muhammedguler/ESP32-ECG-HOLTER/PCB/Bill Of Materials EKG HOLTER.pdf

## Bill Of Materials for EKG HOLTER

Design Title | EKG HOLTER
Author | Muhammed Güler
Document Number | 001
Revision | 1.2
Design Created | Friday, October 27, 2023
Design Last Modified Friday, November 3, 2023

### Total Parts In Design 137

0 Modules
Quantity References | Value | Stock Code | Unit
Cost
Sub-totals: | | | | $0.00
42 Capacitors
Quantity References | Value | Stock Code | Unit
| | | | Cost
3 | C1,C37,C41 | GRM31CR61A107MEA8L | 490-GRM31CR61A107MEA8LCT-
| | | ND (https://www.digikey.com/en/products/detail/murata-electronics/grm31cr61a107mea8l/16033775) | $0.29
17 | C2,C4,C7,C11,C13,C18,C20-C22,C31,
| C33-C34,C36,C38-C40,C42 | CL10B104KB8NNWC | 1276-1935-1-ND (https://www.digikey.com/en/products/detail/samsung-electro-mechanics/CL10B104KB8NNWC/3887593) | $0.02
1 | C3 | CL10B102KB8NNNC | 1276-1018-1-ND (https://www.digikey.com/en/products/detail/samsung-electro-mechanics/CL10B102KB8NNNC/3886676) | $0.03
2 | C5-C6 | CL10C220JB81PNC | 1276-2226-1-ND (https://www.digikey.com/en/products/detail/samsung-electro-mechanics/CL10C220JB81PNC/3887884) | $0.04
2 | C8-C9 | CL10C040CB8NNNC | 1276-1789-1-ND (https://www.digikey.com/en/products/detail/samsung-electro-mechanics/CL10C040CB8NNNC/3887447) | $0.03
11 | C10,C12,C14,C16,C19,C25-C27,C30, | | GRM188R61E106KA73J | 490-GRM188R61E106KA73JCT- | $0.16
C32,C35 | | ND (https://www.digikey.com/en/products/detail/murata-electronics/GRM188R61E106KA73J/9887674)
6 | C15,C17,C23-C24,C28-C29 | TMK107ABJ225KA-T | 587-2909-1-ND (https://www.digikey.com/en/products/detail/taiyo-yuden/TMK107ABJ225KA-T/2648986) | $0.12
Sub-totals: | | | | $3.80
46 Resistors
Quantity References | Value | Stock Code | Unit
| | | | Cost
15 | R1-R5,R7,R12-R13,R15-R16,R34,R37, R43,R45-R46 | 10k | 13-RC0603FR-1010KLCT-ND (https://www.digikey.com/en/products/detail/yageo/RC0603FR-1010KL/12756395) | $0.01
3 | R6,R26,R35 | 0R | 311-0.0GRCT-ND (https://www.digikey.com/en/products/detail/yageo/RC0603JR-070RL/726675) | $0.01
1 | R8 | 10M | 311-10MGRCT-ND (https://www.digikey.com/en/products/detail/yageo/RC0603JR-0710ML/726701) | $0.01
4 | R9,R11,R42,R44 | 220 | 311-220HRCT-ND (https://www.digikey.com/en/products/detail/yageo/RC0603FR-07220RL/727061) | $0.01
5 | R10,R20,R27-R28,R31 | 330 | 13-RC0603FR-10330RLCT-ND (https://www.digikey.com/en/products/detail/yageo/RC0603FR-10330RL/13694144) | $0.01
5 | R14,R17,R36,R38,R40 | 22.6k | 311-22.6KHRCT-ND (https://www.digikey.com/en/products/detail/yageo/RC0603FR-0722K6L/727060) | $0.01
6 | R18-R19,R32-R33,R39,R41 | 100k | 13-RC0603FR-10100KLCT-ND (https://www.digikey.com/en/products/detail/yageo/RC0603FR-10100KL/13694231) | $0.01
5 | R21-R25 | CRCW120622K0FKEAHP | 541-22.0KUCT-ND (https://www.digikey.com/en/products/detail/vishay-dale/CRCW120622K0FKEAHP/2227891) | $0.11
2 | R29-R30 | 1M | 13-RC0603FR-131MLCT-ND (https://www.digikey.com/en/products/detail/yageo/RC0603FR-131ML/13694152) | $0.01
Sub-totals: | | | | $0.94
8 Integrated Circuits
Quantity References | Value | Stock Code | Unit
| | | | Cost
1 | U1 | ADS1293CISQ_NOPB | 296-39852-1-ND (https://www.digikey.com/en/products/detail/texas-instruments/ADS1293CISQ-NOPB/3749460) | $16.02
1 | U2 | MCP7940NT-I_SN | MCP7940NT-I/SNCT-ND (https://www.digikey.com/en/products/detail/microchip-technology/MCP7940NT-I-SN/2665116) | $0.85
1 | U3 | XC6193AA10ER-G | 893-XC6193AA10ER-GCT-ND (https://www.digikey.com/en/products/detail/torex-semiconductor-ltd/XC6193AA10ER-G/12325035) | $0.88
1 | U4 | ESP32-S3-WROOM-1 | 1965-ESP32-S3-WROOM-1- N8CT-ND (https://www.digikey.com/en/products/detail/espressif-systems/ESP32-S3-WROOM-1-N8/15200089) | $3.20
1 | U5 | M24C16-RMN6TP
1 | U6 | MAX77751CEFG | 175-MAX77751CEFG+-ND (https://www.digikey.com/en/products/detail/analog-devices-inc-maxim-integrated/MAX77751CEFG/13157987) | $3.61
1 | U7 | TLV62568PDDCR | 296-50491-1-ND (https://www.digikey.com/en/products/detail/texas-instruments/TLV62568PDDCR/7915913) | $0.38
1 | U8 | MIC2876-AYMT-TR | MIC2876-AYMT-CT-ND (https://www.digikey.com/en/products/detail/microchip-technology/MIC2876-AYMT-TR/5283841) | $0.97
Sub-totals: | | | | $25.91
5 Transistors

Quantity References | Value | Stock Code | Unit
Cost
1 | Q1 | SSM3J328R_LF | SSM3J328RLFCT-ND (https://www.digikey.com/en/products/detail/toshiba-semiconductor-and-storage/SSM3J328R-LF/2753199) | $0.39
4 | Q2-Q5 | NX138BKR | 1727-2662-1-ND (https://www.digikey.com/en/products/detail/nexperia-usa-inc/NX138BKR/5981270) | $0.21
Sub-totals: | | | | $1.23
1 Diodes
Quantity References | Value | Stock Code | Unit
| | | | Cost
1 | D1 | CUS520_H3F | CUS520H3FCT-ND (https://www.digikey.com/en/products/detail/toshiba-semiconductor-and-storage/CUS520-H3F/5114303) | $0.20
Sub-totals: | | | | $0.20
35 Miscellaneous
Quantity References | Value | Stock Code | Unit
| | | | Cost
1 | BAT1 | BK-869 | BK-869-ND (https://www.digikey.com/en/products/detail/mpd-memory-protection-devices/BK-869/2439465) | $0.56
1 | BAT2 | SWR25X-NRTC-S02-RB-BA | S9499-ND (https://www.digikey.com/en/products/detail/sullins-connector-solutions/SWR25X-NRTC-S02-RB-BA/2769660) | $0.15
1 | BATA1 | SWH25X-NULC-S02-UU-BA | S9435-ND (https://www.digikey.com/en/products/detail/sullins-connector-solutions/SWH25X-NULC-S02-UU-BA/2411477) | $0.03
2 | BATB1-BATB2 | SWT25X-URTC-S01-UU-UU | S9473CT-ND (https://www.digikey.com/en/products/detail/sullins-connector-solutions/SWT25X-URTC-S01-UU-UU/2769651) | $0.06
2 | BTN1-BTN2 | TS14-1212-100-BK-160-SCR-
| | D | 2223-TS14-1212-100-BK-160- SCR-D-ND (https://www.digikey.com/en/products/detail/cui-devices/TS14-1212-100-BK-160-SCR-D/16562757) | $0.24
2 | BTNN1-BTNN2 | PTS647SK38SMTR2LFS | PTS647SK38SMTR2LFSCT-ND (https://www.digikey.com/en/products/detail/c-k/PTS-647-SK38-SMTR2-LFS/9649862) | $0.20
1 | BUZZER1 | SMT-0825-S-HT-R | 668-SMT-0825-S-HT-RCT-ND (https://www.digikey.com/en/products/detail/pui-audio-inc/SMT-0825-S-HT-R/13165908) | $1.13
5 | ECG1-ECG5 | DIN42802-1 | DIN42802-1 (https://www.aliexpress.com/i/2251832820496981.html?gatewayAdapt=bra2glo4itemAdapt) | $5.00
5 | ESD1-ESD5 | ESD03A5V5R17V | ESD03A5V5R17VCT-ND (https://www.digikey.com/en/products/detail/stackpole-electronics-inc/ESD03A5V5R17V/2239266) | $0.18
3 | L1,L3,L5 | BLM18KG102SN1D | 490-17349-1-ND (https://www.digikey.com/en/products/detail/murata-electronics/BLM18KG102SN1D/7798421) | $0.10
3 | L2,L4,L6 | SRP3212A-3R3M | 118-SRP3212A-3R3MCT-ND (https://www.digikey.com/en/products/detail/bourns-inc/SRP3212A-3R3M/16546469) | $0.27
1 | LED1 | B38G3RGB-10D0003H2U1930 | 3147- B38G3RGB-10D0003H2U1930CT-
| | | ND (https://www.digikey.com/en/products/detail/harvatek-corporation/B38G3RGB-10D0003H2U1930/13588733) | $0.11
1 | NTC1 | NCU18XH103E60RB | 490-18164-1-ND (https://www.digikey.com/en/products/detail/murata-electronics/NCU18XH103E60RB/8323959) | $0.06
1 | PROG1 | 61300611121 | 732-5319-ND (https://www.digikey.com/en/products/detail/w%C3%BCrth-elektronik/61300611121/4846833) | $0.30
1 | SD1 | 0475710001 | WM9731CT-ND (https://www.digikey.com/en/products/detail/molex/0475710001/3262277?s=N4IgTCBcDaIAwBYDsBWJBGOX0gLoF8g) | $1.15
1 | TVS1 | USBLC6-2SC6 | 497-5235-1-ND (https://www.digikey.com/en/products/detail/stmicroelectronics/USBLC6-2SC6/1040559) | $0.61
1 | TVS2 | EMIF06-MSD02N16 | 497-8751-1-ND (https://www.digikey.com/en/products/detail/stmicroelectronics/EMIF06-MSD02N16/2043592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) | $1.12
1 | USB1 | USB4105GFA | 2073-USB4105-GF-ACT-ND (https://www.digikey.com/en/products/detail/gct/USB4105-GF-A/11198441) | $0.81
1 | X1 | SC32S-7PF20PPM | 728-1074-1-ND (https://www.digikey.com/en/products/detail/seiko-instruments/SC32S-7PF20PPM/4931504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) | $0.38
1 | X2 | ABLS-4 | 535-14922-1-ND (https://www.digikey.com/en/products/detail/abracon-llc/ABLS-4-096MHZ-20-B-4-Y-T/9997830) | $0.24
Sub-totals: | | | | $34.66
Totals: | | | | $66.74

Wednesday, January 10, 2024 7:30:53 PM
