muhammedguler/ESP32-ECG-HOLTER/PCB/sema.PDF

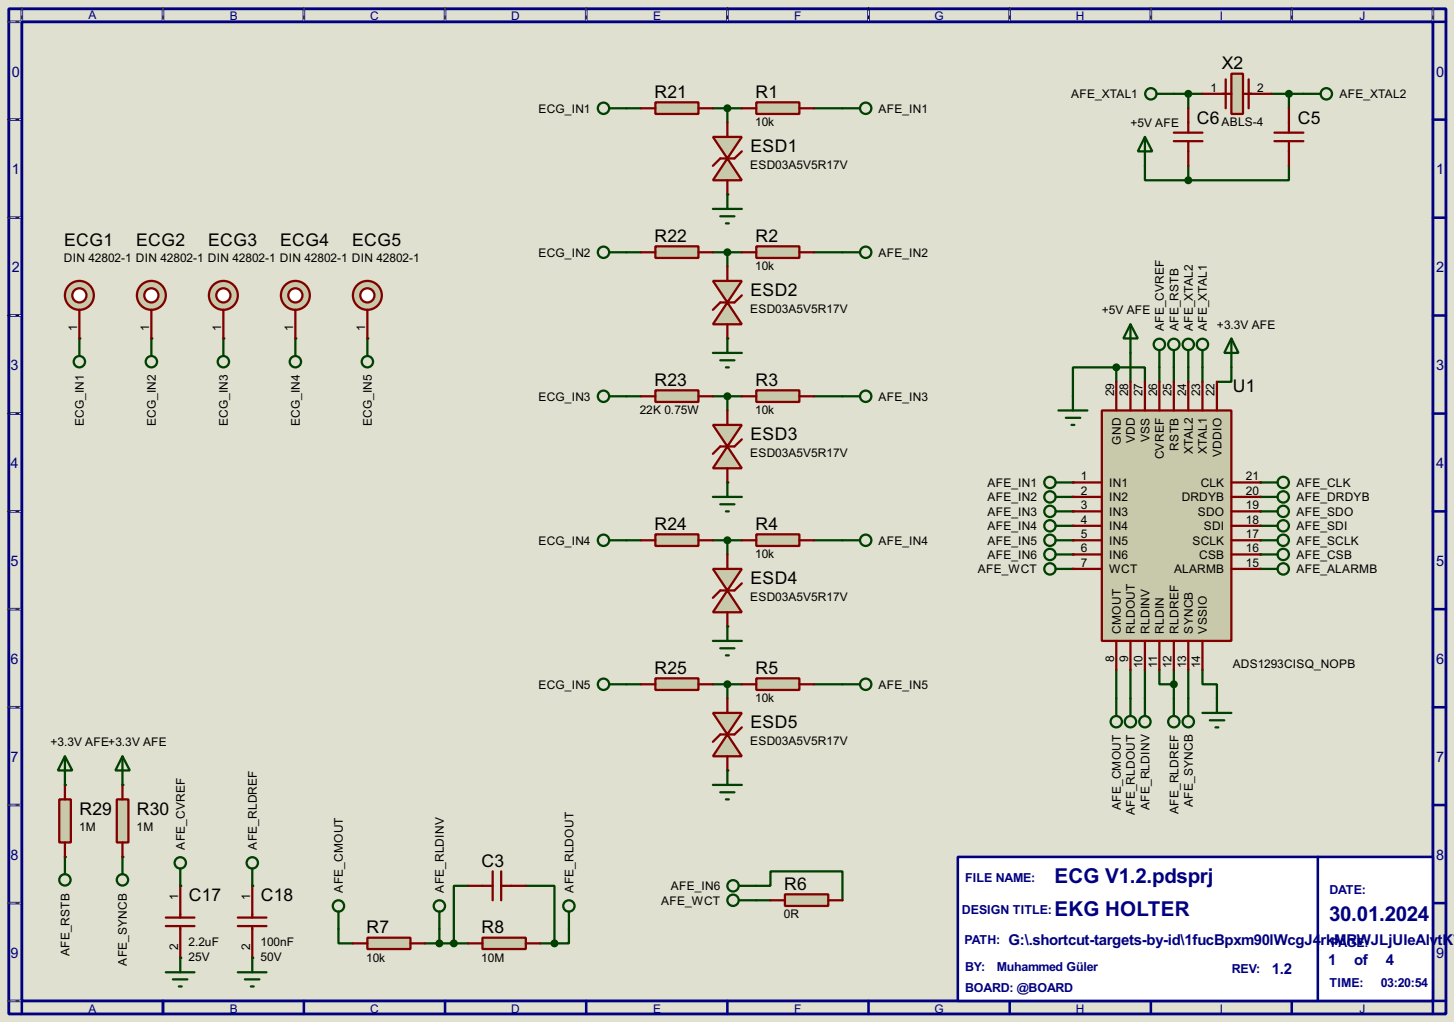
[picture p1: page 1]

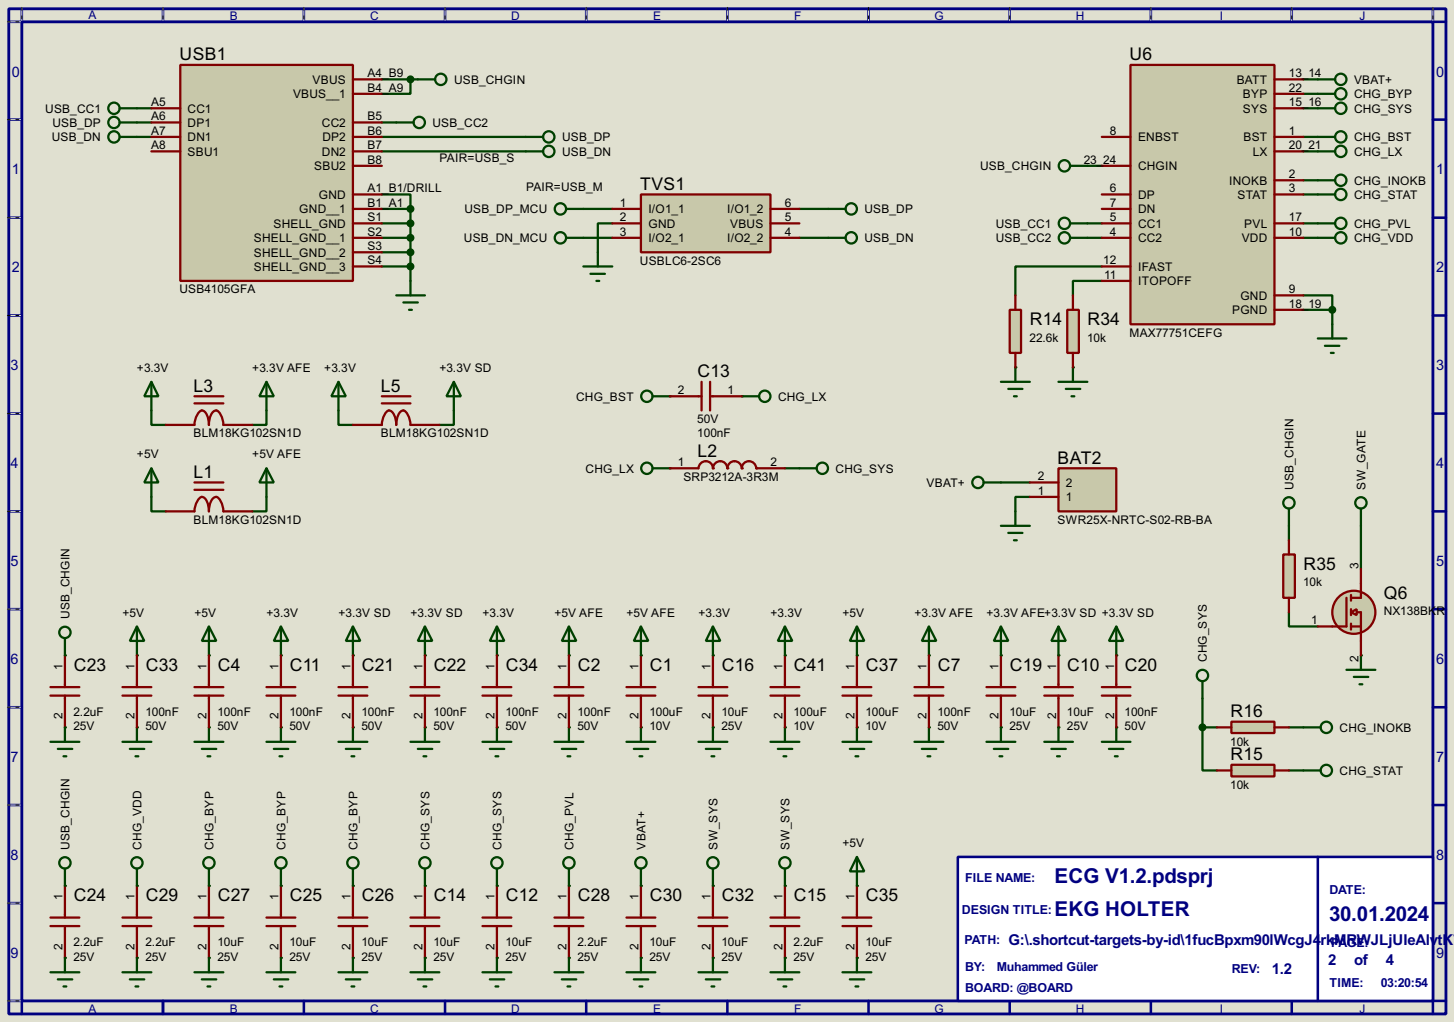
[picture p2: page 2]

DESIGN TITLE:EKG HOLTER

Muhammed Güler PATH: G:\.shortcut-targets-by-id\1fucBpxm90lWcgJ4rkMRWJLjUIeAlvtK7\Muhammed Güler\PCB\ECG V1.2.pdsprj

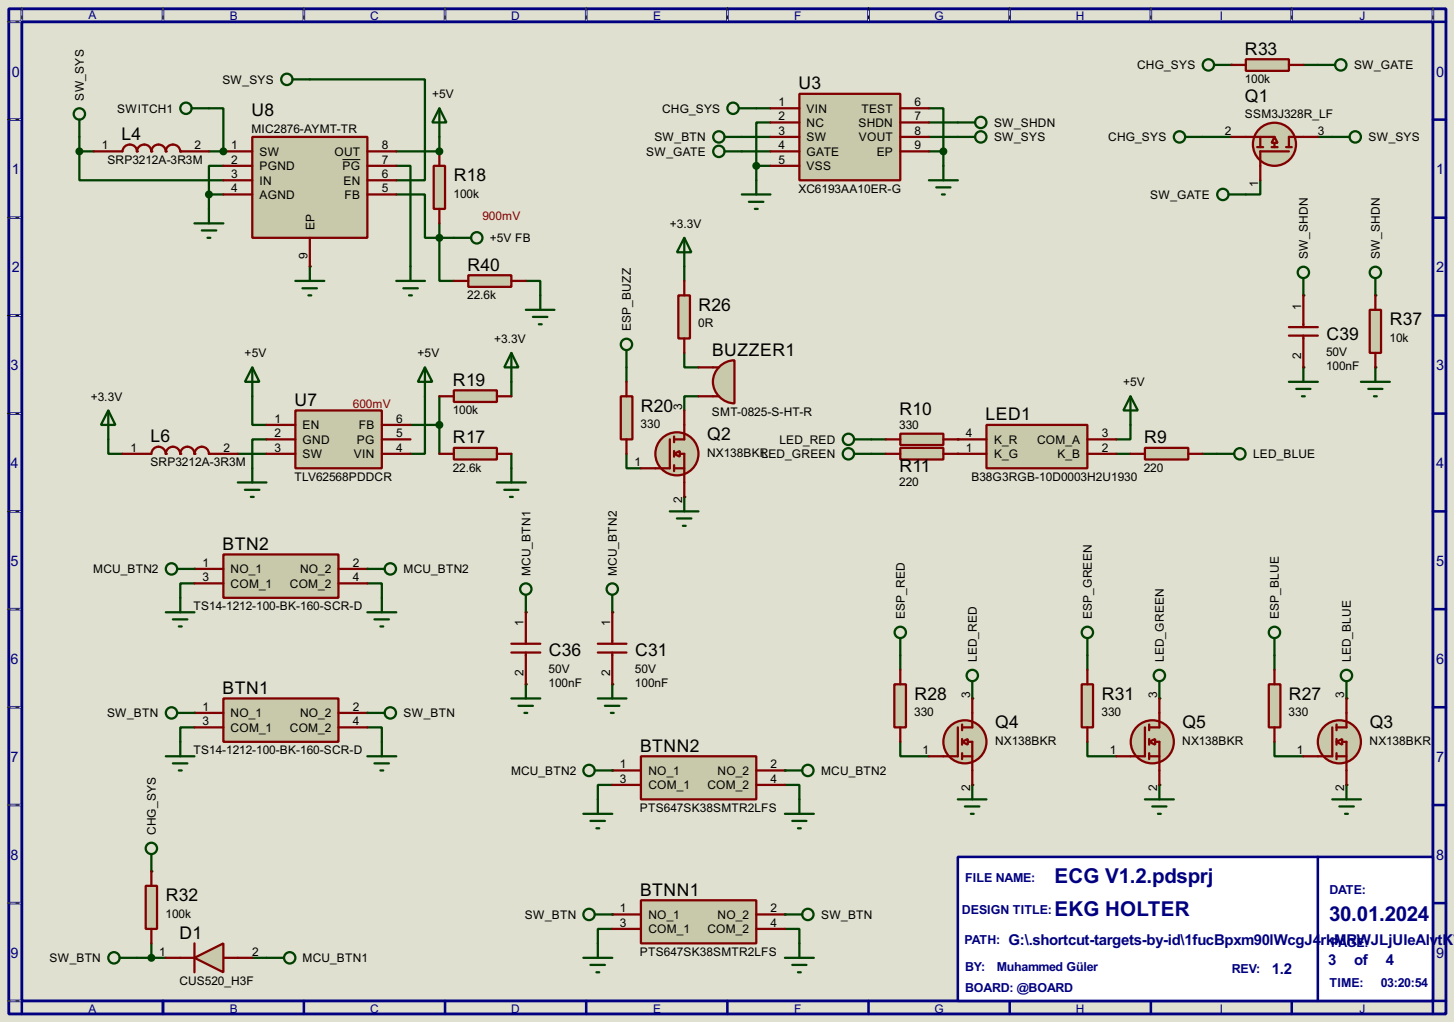
[picture p3: page 3]

DESIGN TITLE:EKG HOLTER

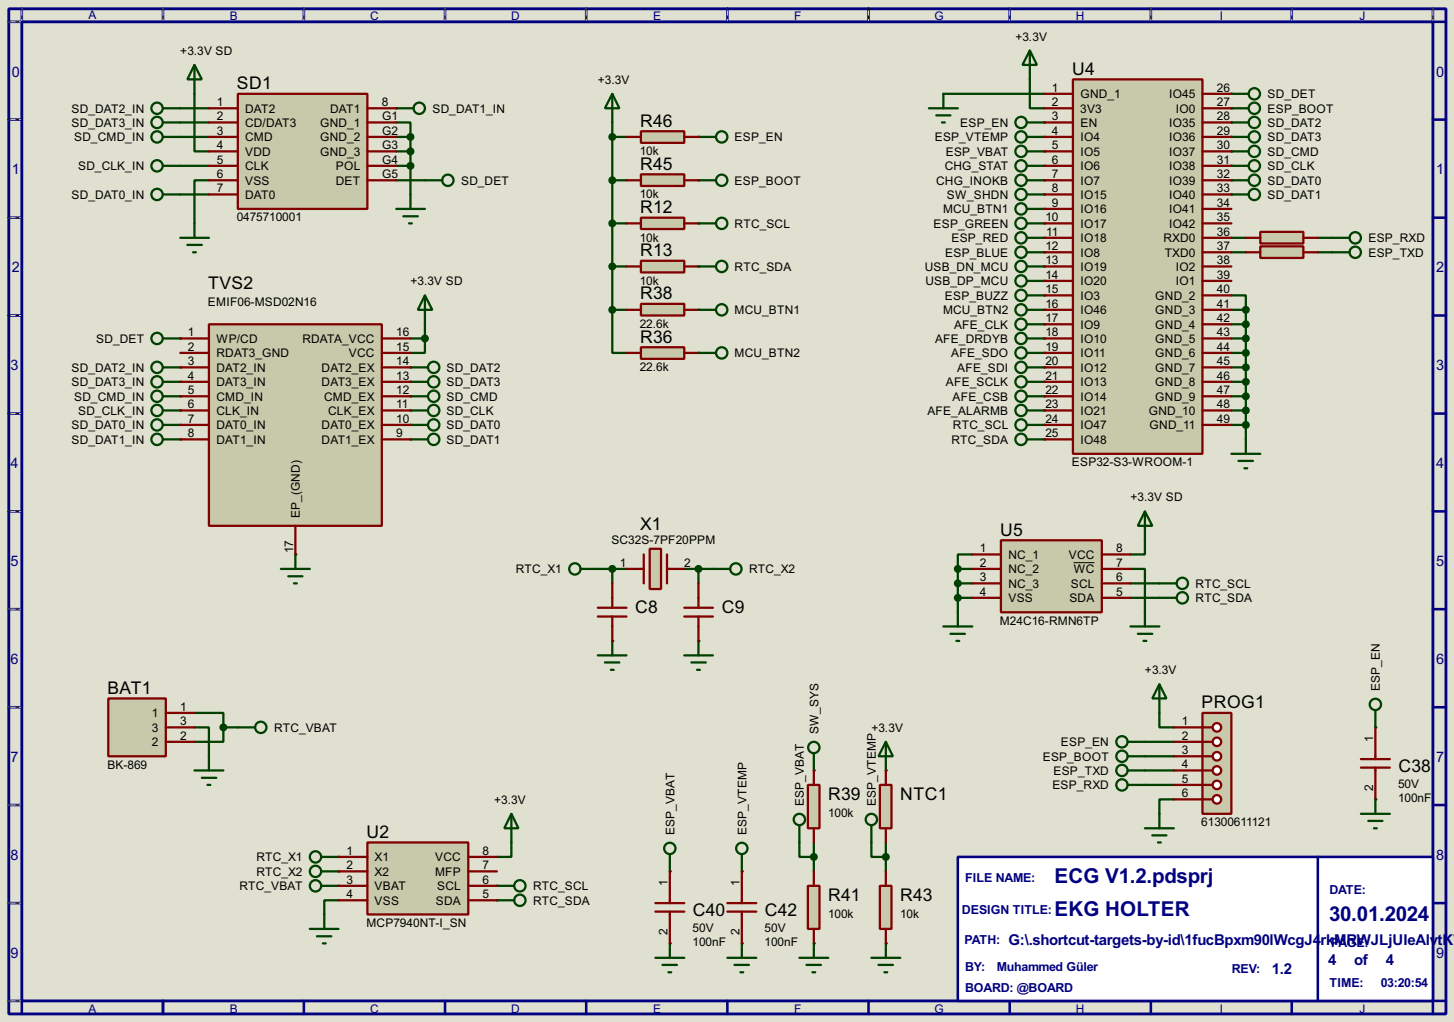
[picture p4: page 4]

DESIGN TITLE:EKG HOLTER
