muhammedguler/ESP32-ECG-HOLTER/PCB/ECG V1.3.PDF

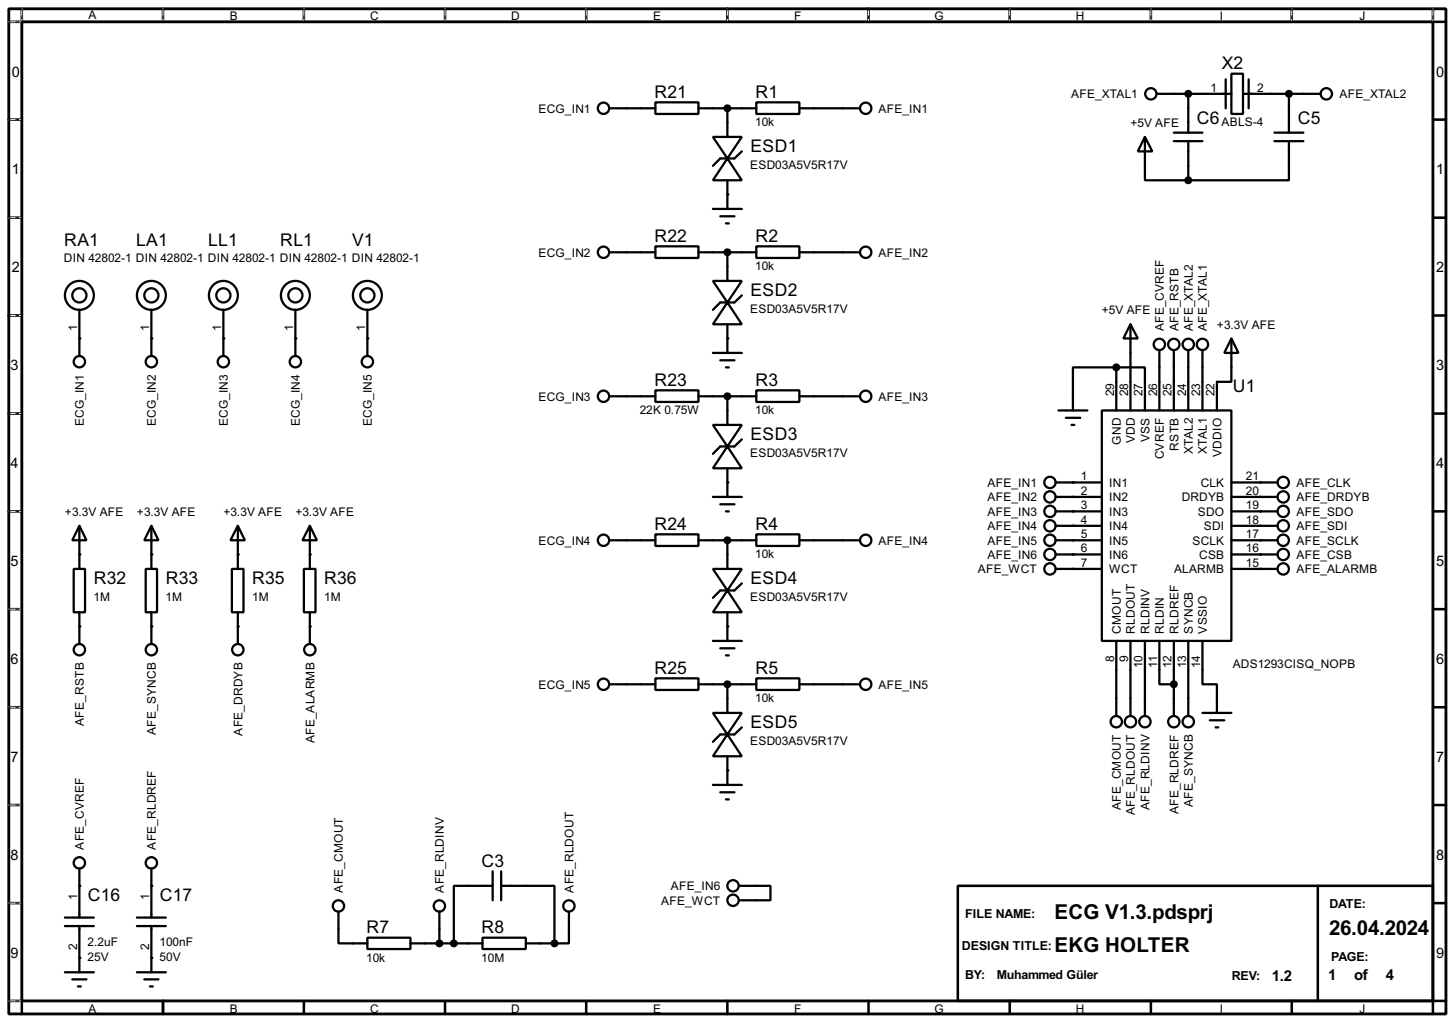
[picture p5: page 1]

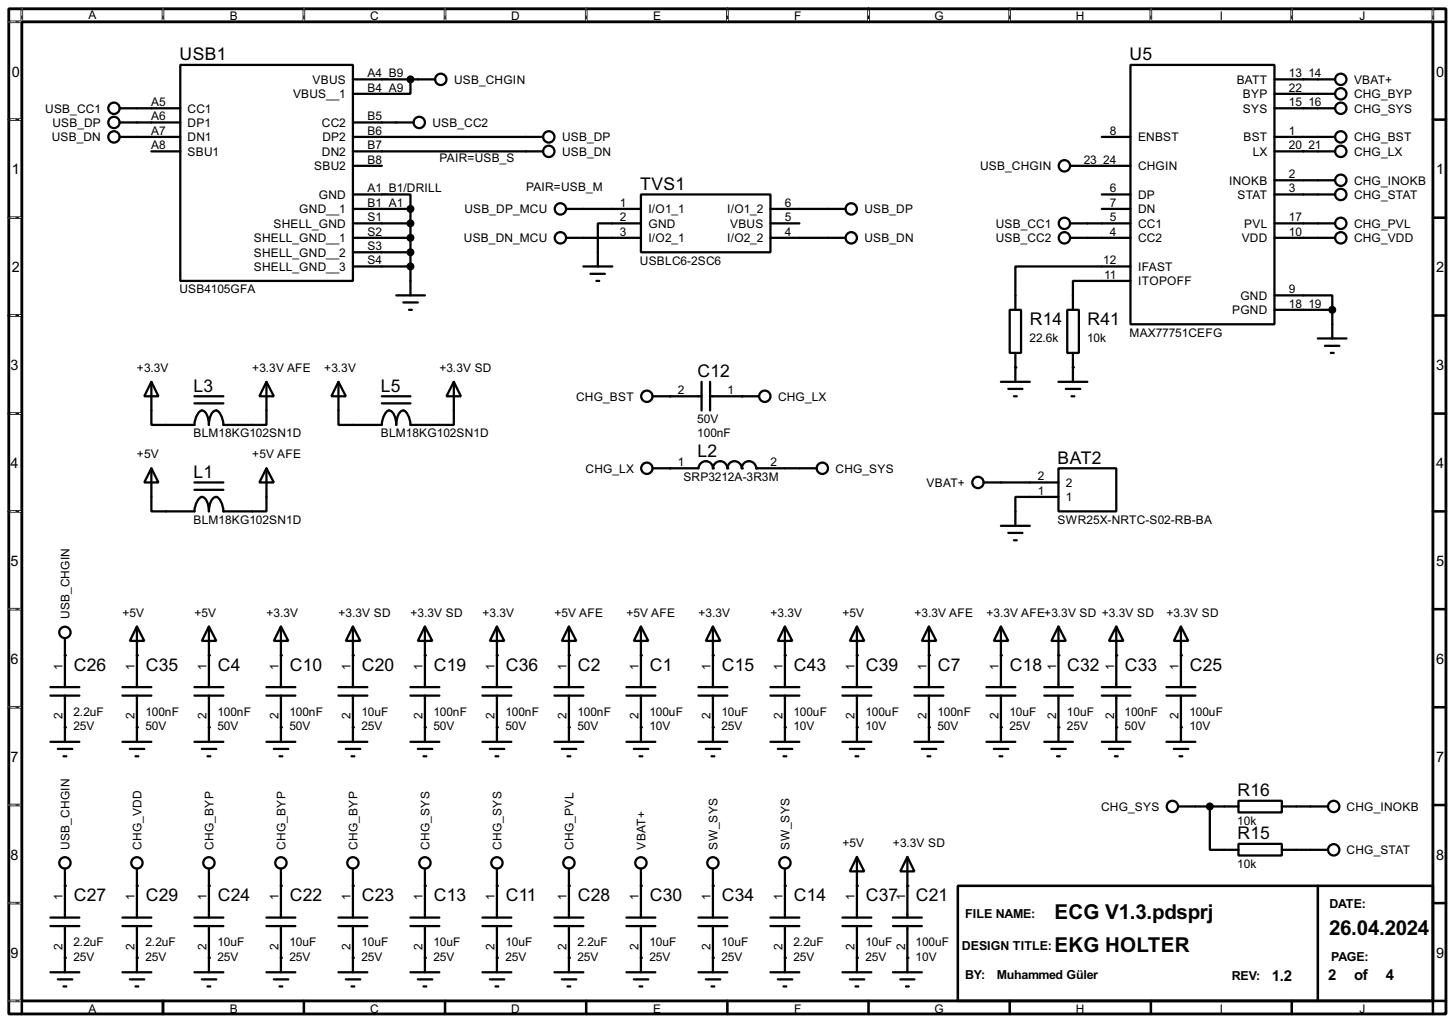
[picture p6: page 2]

DESIGN TITLE:EKG HOLTER

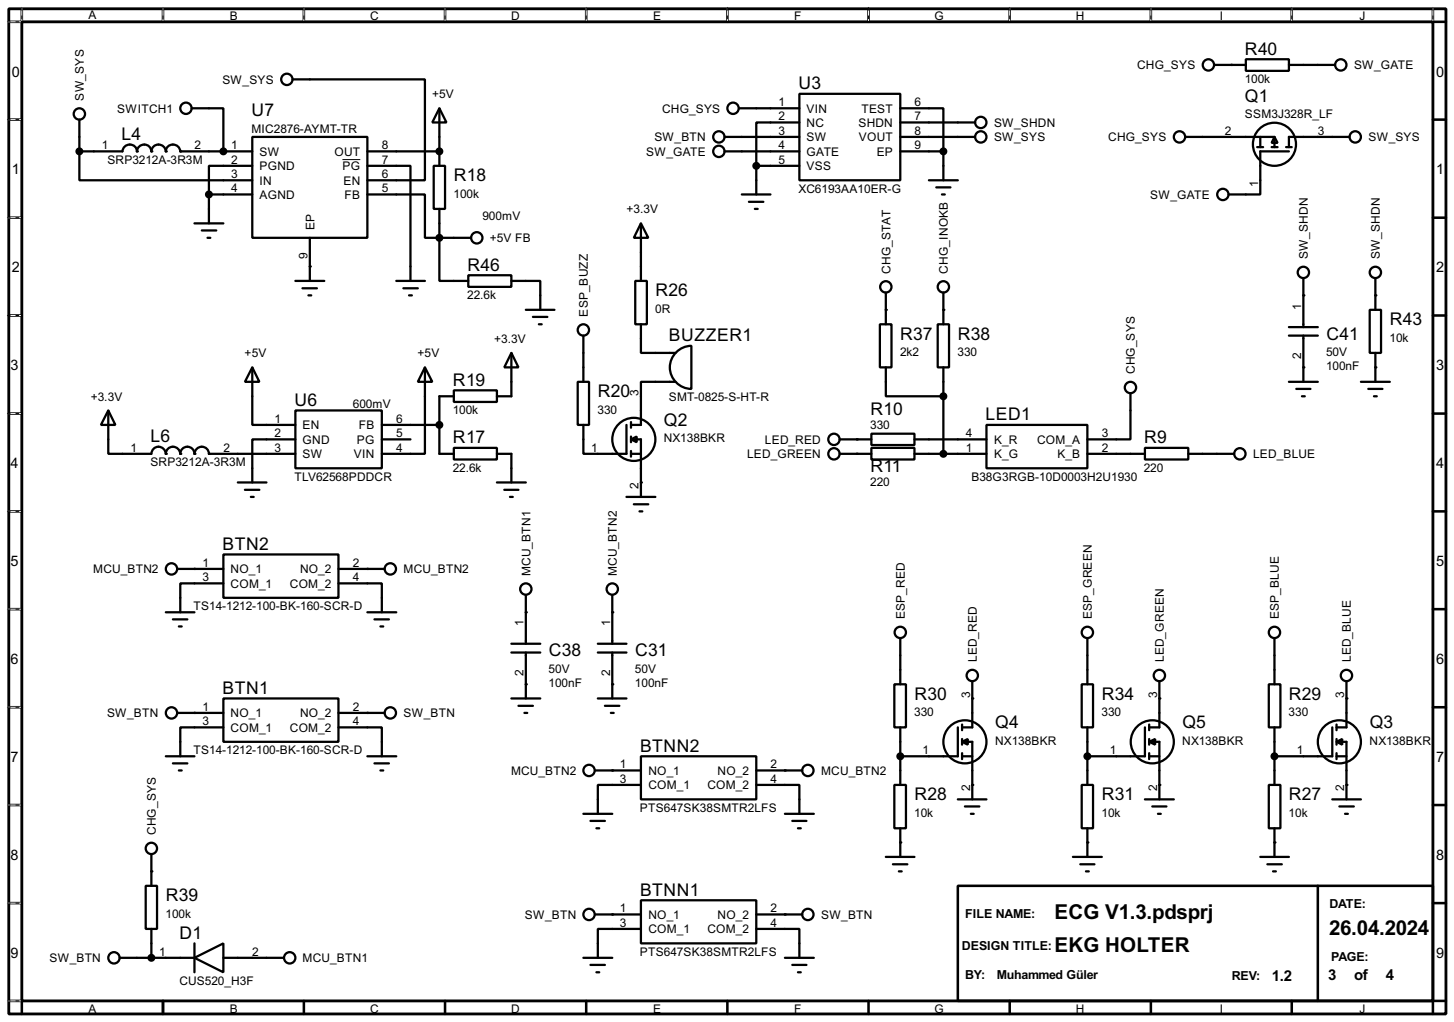
[picture p7: page 3]

DESIGN TITLE:EKG HOLTER SW_BTN

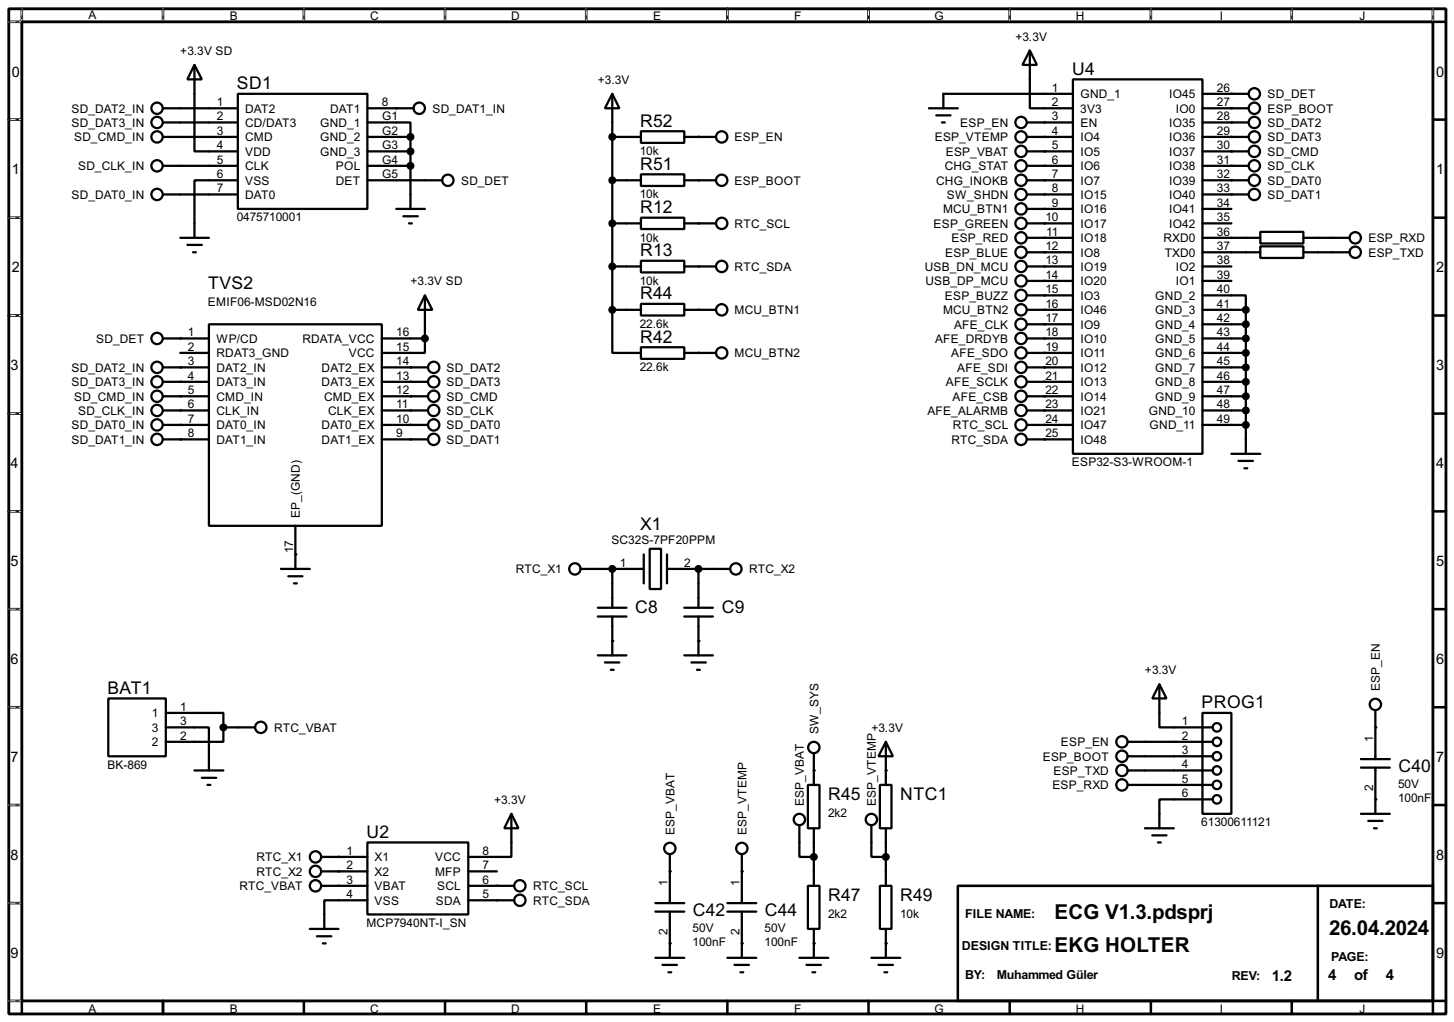
[picture p8: page 4]

DESIGN TITLE:EKG HOLTER
