muhammedguler/ESP32-ECG-HOLTER/PCB/ECG V1.2.PDF

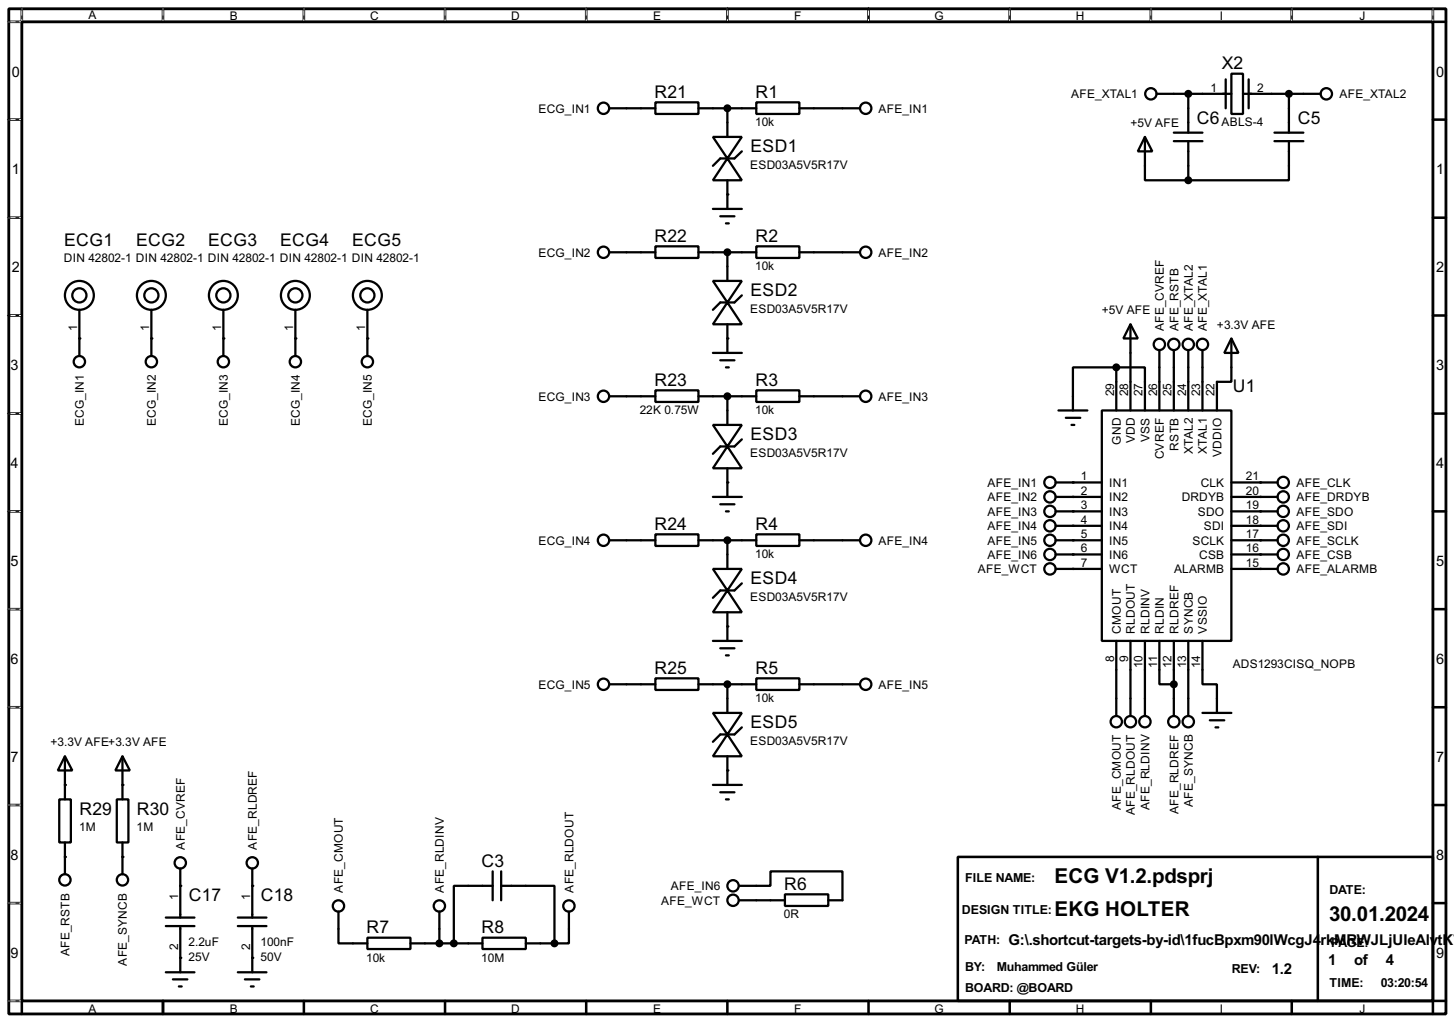
[picture p19: page 1]

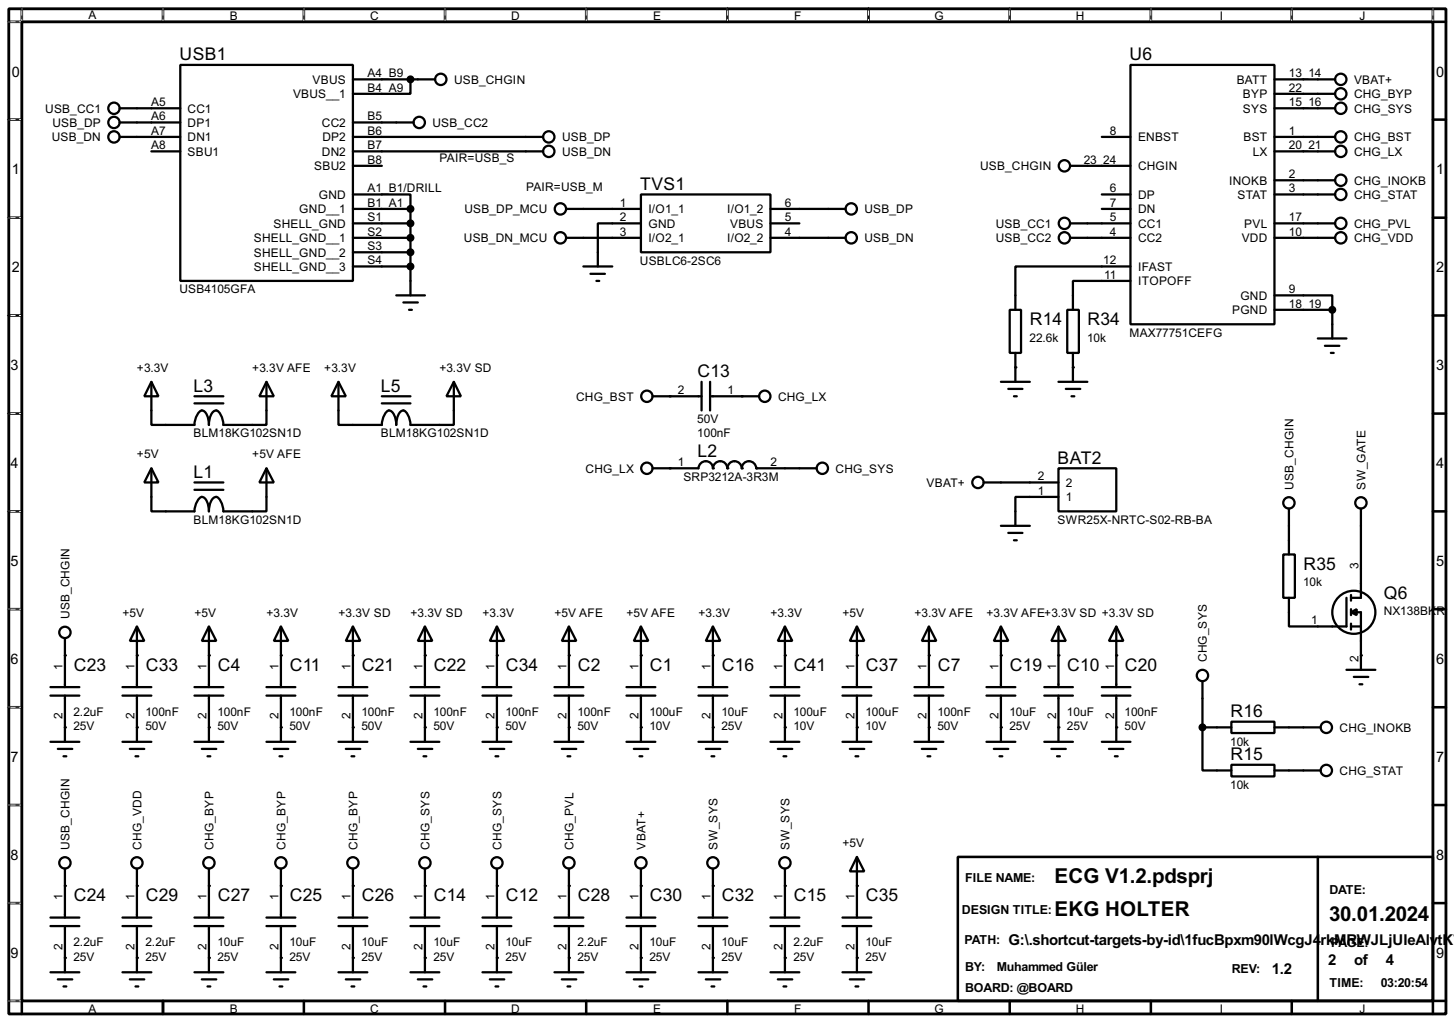
[picture p20: page 2]

DESIGN TITLE:EKG HOLTER

Muhammed Güler PATH: G:\.shortcut-targets-by-id\1fucBpxm90lWcgJ4rkMRWJLjUIeAlvtK7\Muhammed Güler\PCB\ECG V1.2.pdsprj

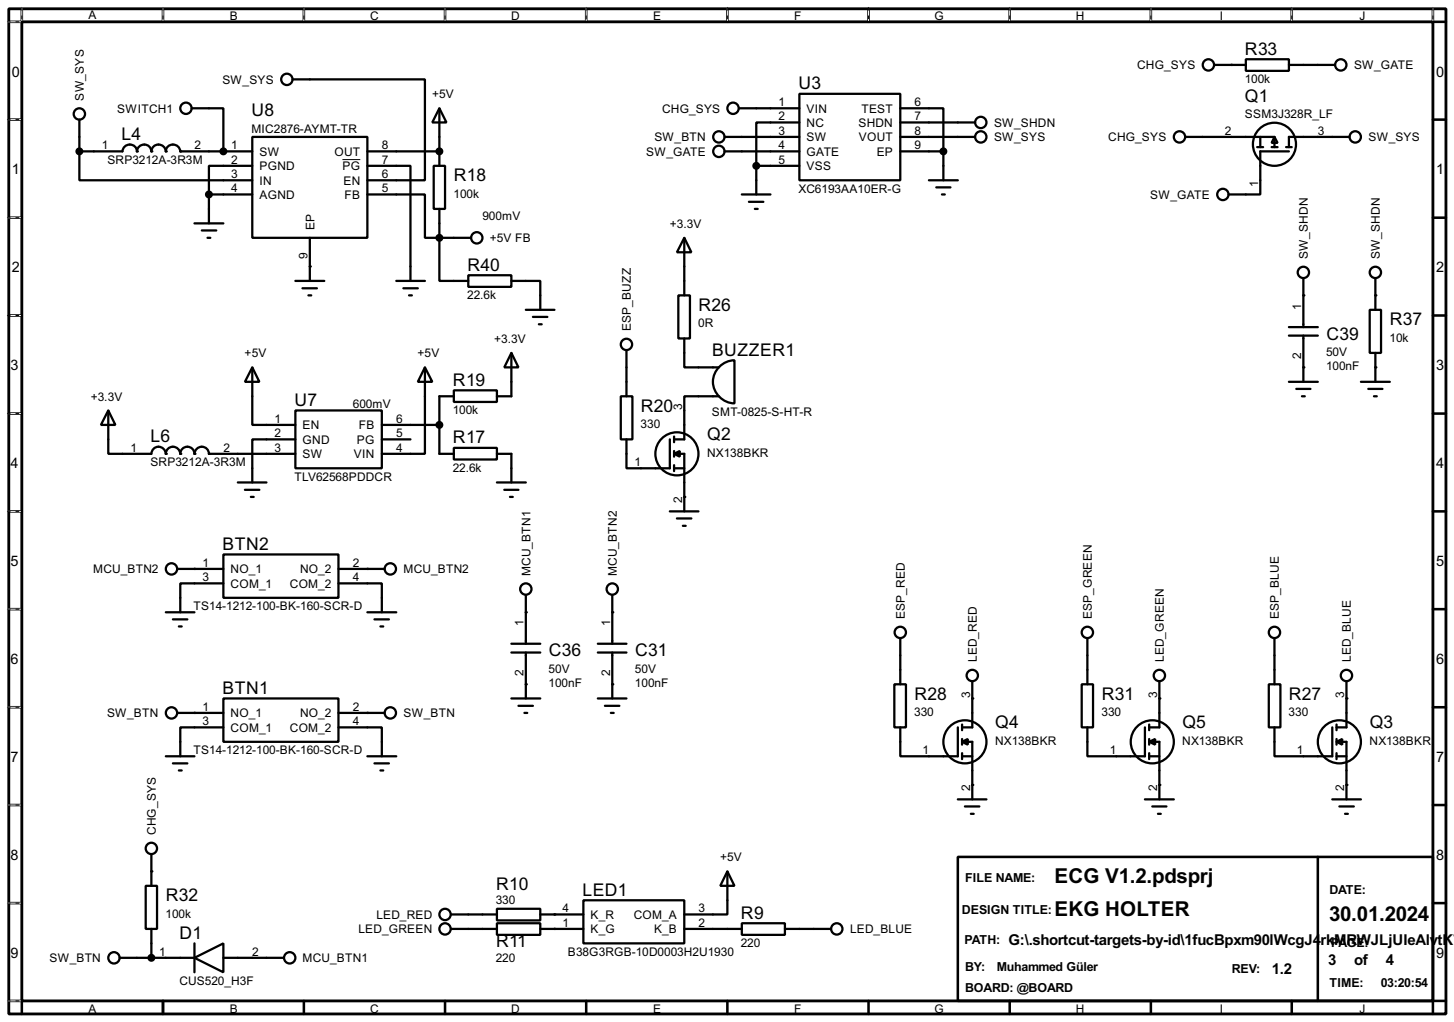
[picture p21: page 3]

DESIGN TITLE:EKG HOLTER

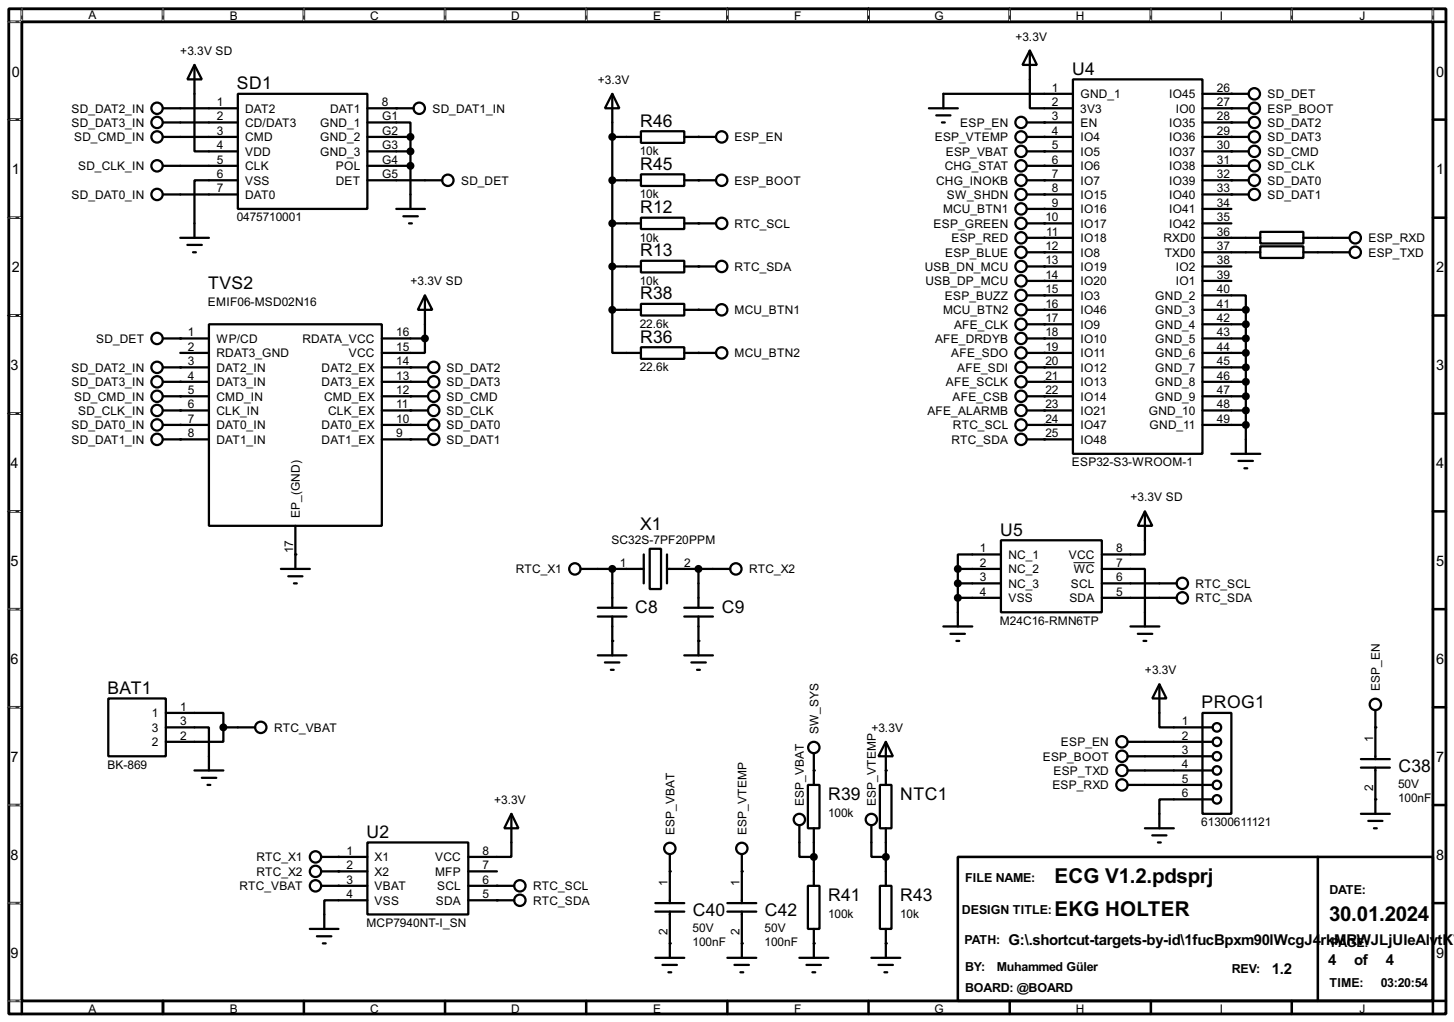
[picture p22: page 4]

DESIGN TITLE:EKG HOLTER
