muhammedguler/ESP32-ECG-HOLTER/(list of files, drawings)

Other design files:
PCB/ECG V1.1.pdsprj
PCB/ECG V1.2.pdsprj
PCB/ECG V1.3.pdsprj
PCB/ECG.pdsprj
PCB/Project Backups/ECG V1.2 [20240424, 11-50-18].pdsprj
PCB/Project Backups/ECG V1.2 [20240424, 11-50-30].pdsprj
PCB/Project Backups/ECG V1.2 [20240424, 11-51-49].pdsprj
PCB/Project Backups/ECG V1.2 [20240424, 11-51-51].pdsprj
PCB/Project Backups/ECG V1.2 [20240424, 13-41-26].pdsprj
PCB/Project Backups/ECG V1.2 [20240424, 13-41-31].pdsprj
PCB/Project Backups/ECG V1.2 [20240424, 17-04-33].pdsprj
PCB/Project Backups/ECG V1.2 [20240424, 17-05-45].pdsprj
PCB/Project Backups/ECG V1.2 [20240424, 17-06-13].pdsprj
PCB/Project Backups/ECG V1.2 [20240424, 17-39-44].pdsprj
PCB/Project Backups/ECG V1.3 [20240425, 14-21-31].pdsprj
PCB/Project Backups/ECG V1.3 [20240425, 14-24-04].pdsprj
PCB/Project Backups/ECG V1.3 [20240425, 14-36-05].pdsprj
PCB/Project Backups/ECG V1.3 [20240426, 11-07-48].pdsprj
PCB/Project Backups/ECG V1.3 [20240426, 11-11-24].pdsprj
PCB/Project Backups/ECG V1.3 [20240426, 11-27-17].pdsprj
PCB/Project Backups/ECG V1.3 [20240426, 11-27-18].pdsprj
PCB/Project Backups/ECG V1.3 [20240426, 11-27-19].pdsprj
PCB/Project Backups/ECG V1.3 [20240603, 13-27-15].pdsprj
PCB/Project Backups/ECG V1.3 [20240603, 13-27-16].pdsprj
