muhammedguler/ESP32-ECG-HOLTER/BleUart/defines.h

#ifndef defines
#define defines

/*
ESP32'nin pin bağlantılarının tanımlamaları
*/


#define Buzzer 3
#define VTemp 4
#define VBat 5
#define ChgStat 6
#define ChgInok 7
#define BlueLED 8
#define AdsCLK 9
#define AdsDrdy 10
#define AdsSDO 11
#define AdsSDI 12
#define AdsSCLK 13
#define AdsCS 14
#define SwShdn 15
#define Buton1 16
#define GreenLED 17
#define RedLED 18
#define DnUSB 19
#define DpUSB 20
#define AdsALARM 21
#define SdCmd 37
#define SdCLK 38
#define SdDat0 39
#define SdDat1 40
#define SdDat2 35
#define SdDat3 36
#define SdDet 45
#define Buton2 46
#define RtcSCL 47
#define RtcSDA 48

#endif
