muhammedguler/ESP32-ECG-HOLTER/BleUart/songs.cpp

#include "songs.h"

#define BUZZER_PIN 4
#define BUZZER_CHANNEL 0

///ToneESP32 buzzer(BUZZER_PIN, BUZZER_CHANNEL);
int BuzzerPin;
void BuzzerInit(int pin) {
    BuzzerPin = pin;
    ledcAttach(pin, 12000, 8);
}

// la fonction qui joue les chansons
void beep(int note, int duration) {
    ledcWriteTone(BuzzerPin, note);
    delay(duration);
    ledcWrite(BuzzerPin, 0);
    delay(duration * 0.25);
}

//******* Starwars ****************

void Starwars() {
    //firstSection
    beep(NOTE_A4, 500);
    beep(NOTE_A4, 500);
    beep(NOTE_A4, 500);
    beep(NOTE_F4, 350);
    beep(NOTE_C5, 150);
    beep(NOTE_A4, 500);
    beep(NOTE_F4, 350);
    beep(NOTE_C5, 150);
    beep(NOTE_A4, 650);
    delay(500);
    beep(NOTE_E5, 500);
    beep(NOTE_E5, 500);
    beep(NOTE_E5, 500);
    beep(NOTE_F5, 350);
    beep(NOTE_C5, 150);
    beep(NOTE_GS4, 500);
    beep(NOTE_F4, 350);
    beep(NOTE_C5, 150);
    beep(NOTE_A4, 650);
    delay(500);
    //secondSection
    beep(NOTE_A5, 500);
    beep(NOTE_A4, 300);
    beep(NOTE_A4, 150);
    beep(NOTE_A5, 500);
    beep(NOTE_GSH, 325);
    beep(NOTE_G5, 175);
    beep(NOTE_FS5, 125);
    beep(NOTE_F5, 125);
    beep(NOTE_FS5, 250);
    delay(325);
    beep(NOTE_AS, 250);
    beep(NOTE_DS5, 500);
    beep(NOTE_D5, 325);
    beep(NOTE_CS5, 175);
    beep(NOTE_C5, 125);
    beep(NOTE_AS4, 125);
    beep(NOTE_C5, 250);
    delay(350);
    //Variant 1
    beep(NOTE_F4, 250);
    beep(NOTE_GS4, 500);
    beep(NOTE_F4, 350);
    beep(NOTE_A4, 125);
    beep(NOTE_C5, 500);
    beep(NOTE_A4, 375);
    beep(NOTE_C5, 125);
    beep(NOTE_E5, 650);
    delay(500);
    //secondSection
    beep(NOTE_A5, 500);
    beep(NOTE_A4, 300);
    beep(NOTE_A4, 150);
    beep(NOTE_A5, 500);
    beep(NOTE_GSH, 325);
    beep(NOTE_G5, 175);
    beep(NOTE_FS5, 125);
    beep(NOTE_F5, 125);
    beep(NOTE_FS5, 250);
    delay(325);
    beep(NOTE_AS, 250);
    beep(NOTE_DS5, 500);
    beep(NOTE_D5, 325);
    beep(NOTE_CS5, 175);
    beep(NOTE_C5, 125);
    beep(NOTE_AS4, 125);
    beep(NOTE_C5, 250);
    delay(350);
    //Variant 2
    beep(NOTE_F4, 250);
    beep(NOTE_GS4, 500);
    beep(NOTE_F4, 375);
    beep(NOTE_C5, 125);
    beep(NOTE_A4, 500);
    beep(NOTE_F4, 375);
    beep(NOTE_C5, 125);
    beep(NOTE_A4, 650);
    delay(650);
}

//******* Game Of Thrones ****************
void GameOfThrones() {
    for (int i = 0; i < 3; i++) {
        beep(NOTE_G4, 500);
        beep(NOTE_C4, 500);
        beep(NOTE_DS4, 250);
        beep(NOTE_F4, 250);
    }

    for (int i = 0; i < 3; i++) {
        beep(NOTE_G4, 500);
        beep(NOTE_C4, 500);
        beep(NOTE_E4, 250);
        beep(NOTE_F4, 250);
    }

    beep(NOTE_G4, 500);
    beep(NOTE_C4, 500);
    beep(NOTE_DS4, 250);
    beep(NOTE_F4, 250);
    beep(NOTE_D4, 500);

    for (int i = 0; i < 2; i++) {
        beep(NOTE_G3, 500);
        beep(NOTE_AS3, 250);
        beep(NOTE_C4, 250);
        beep(NOTE_D4, 500);
    }

    beep(NOTE_G3, 500);
    beep(NOTE_AS3, 250);
    beep(NOTE_C4, 250);
    beep(NOTE_D4, 1000);
    beep(NOTE_F4, 1000);
    beep(NOTE_AS3, 1000);
    beep(NOTE_DS4, 250);
    beep(NOTE_D4, 250);
    beep(NOTE_F4, 1000);
    beep(NOTE_AS3, 1000);
    beep(NOTE_DS4, 250);
    beep(NOTE_D4, 250);
    beep(NOTE_C4, 500);

    for (int i = 0; i < 2; i++) {
        beep(NOTE_GS3, 250);
        beep(NOTE_AS3, 250);
        beep(NOTE_C4, 500);
        beep(NOTE_F3, 500);
    }

    beep(NOTE_G4, 1000);
    beep(NOTE_C4, 1000);
    beep(NOTE_DS4, 250);
    beep(NOTE_F4, 250);
    beep(NOTE_G4, 1000);
    beep(NOTE_C4, 1000);
    beep(NOTE_DS4, 250);
    beep(NOTE_F4, 250);
    beep(NOTE_D4, 500);

    for (int i = 0; i < 3; i++) {
        beep(NOTE_G3, 500);
        beep(NOTE_AS3, 250);
        beep(NOTE_C4, 250);
        beep(NOTE_D4, 500);
    }
}


//******* Happy Birthday ****************
void HappyBirthday() {
    beep(NOTE_G3, 200);
    beep(NOTE_G3, 200);
    beep(NOTE_A3, 500);
    beep(NOTE_G3, 500);
    beep(NOTE_C4, 500);
    beep(NOTE_B3, 1000);
    beep(NOTE_G3, 200);
    beep(NOTE_G3, 200);
    beep(NOTE_A3, 500);
    beep(NOTE_G3, 500);
    beep(NOTE_D4, 500);
    beep(NOTE_C4, 1000);
    beep(NOTE_G3, 200);
    beep(NOTE_G3, 200);
    beep(NOTE_G4, 500);
    beep(NOTE_E4, 500);
    beep(NOTE_C4, 500);
    beep(NOTE_B3, 500);
    beep(NOTE_A3, 750);
    beep(NOTE_F4, 200);
    beep(NOTE_F4, 200);
    beep(NOTE_E4, 500);
    beep(NOTE_C4, 500);
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
    delay(50);
    beep(NOTE_E4, 200);
    beep(NOTE_A4, 150);
    beep(NOTE_B4, 150);
    beep(NOTE_A4, 150);
    beep(NOTE_GS4, 150);
    beep(NOTE_AS4, 150);
    beep(NOTE_GS4, 150);
    beep(NOTE_G4, 100);
    beep(NOTE_D4, 100);
    beep(NOTE_E4, 600);
    Serial.println(millis());
}
