muhammedguler/ESP32-ECG-HOLTER/(commit log)

2024-03-03 Create 400hz 4000 order 50 100 150 200 cut filter.fda
2024-05-21 PCB tasarımı eklendi
    [ECG V1.1.pdsprj, ECG V1.2 [20240424, 11-50-18].pdsprj, ECG V1.2 [20240424, 11-50-30].pdsprj, ECG V1.2 [20240424, 11-51-49].pdsprj, ECG V1.2 [20240424, 11-51-51].pdsprj, ECG V1.2 [20240424, 13-41-26].pdsprj, ECG V1.2 [20240424, 13-41-31].pdsprj, ECG V1.2 [20240424, 17-04-33].pdsprj]
